471654852/BTComputerSwitch/ENGR Project 01/QQ20180418-174442.png

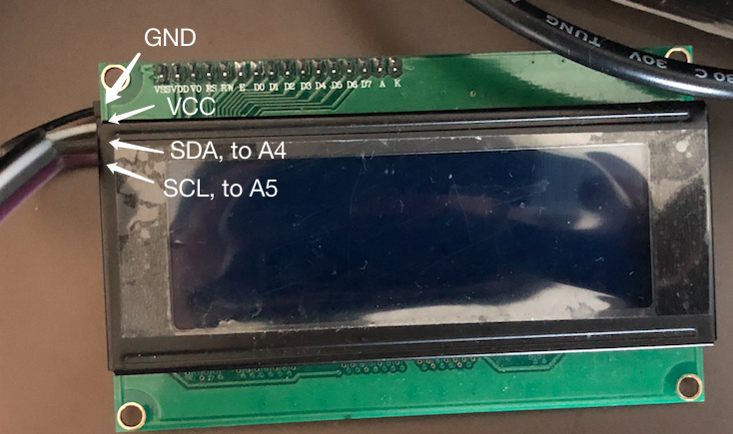
ENGR Project 01/QQ20180418-174442.png
