471654852/BTComputerSwitch/ENGR Project 01/QQ20180418-173207.png

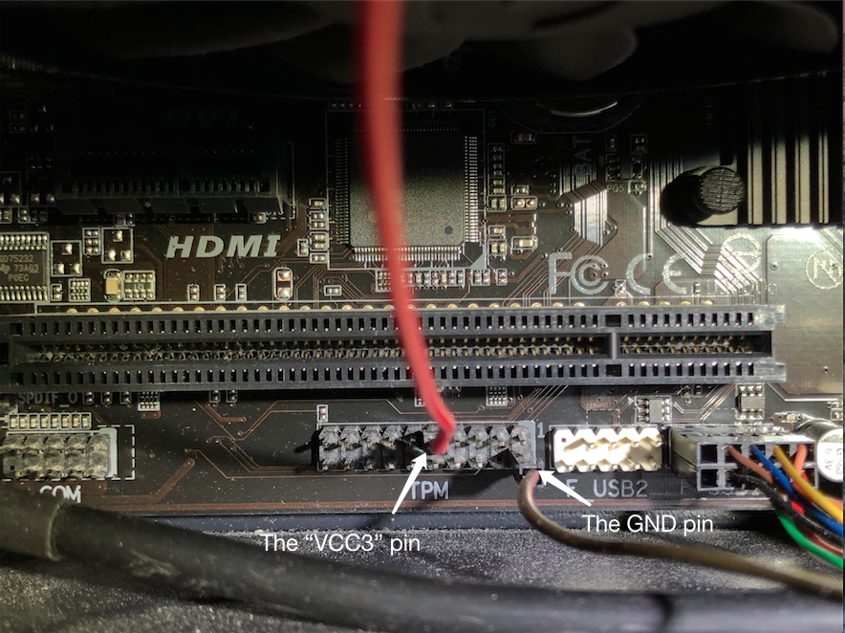
ENGR Project 01/QQ20180418-173207.png
