471654852/BTComputerSwitch/Project.pdf

### 7. Problem Solving

1. Problem statement

Many people forget to turn off their computer when they leave the house, which would

waste a lot of energy. I will design and make a Bluetooth switch for a computer that

connects the ON OFF switch of the computer to their phone. This allows a user who is in the

range of the Bluetooth connection to control the ON OFF switch through their phone. If the

user is outside of the range of the Bluetooth connection, then the switch will turn off the

computer automatically. This will reduce the energy consumption.

### 2. Diagrams

Figure 1.1
The diagram below shows the function of each pin on the TPM header.

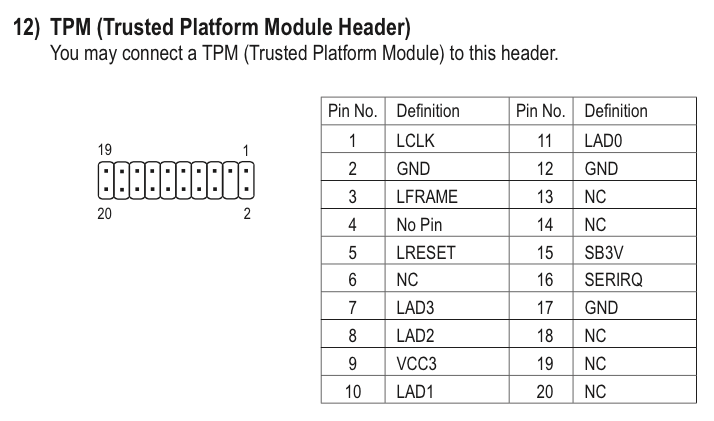
[picture p3: figure]

The TPM header on a motherboard.
From: https://www.gigabyte.com/Motherboard/GA-A320M-HD2-rev-10#support-manual

Figure 1.2
The diagram below shows the function of each pin on the front panel header.

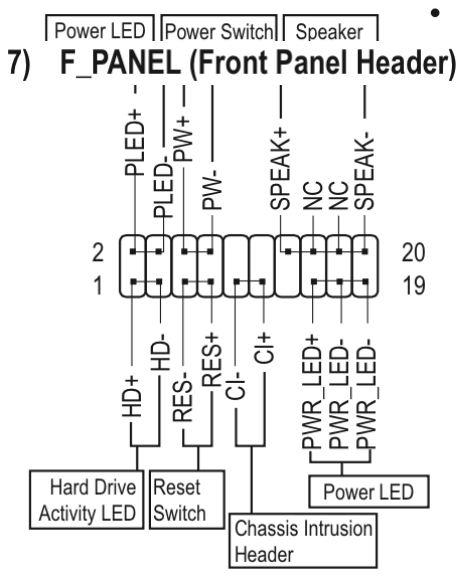
[picture p4: figure]

The front panel header on a mother board.
From: https://www.gigabyte.com/Motherboard/GA-A320M-HD2-rev-10#support-manual

Figure 2
The diagram below explains the voltage divider Law.
This is very important to make a 5V microcontroller and a 3.3V Bluetooth module work together.

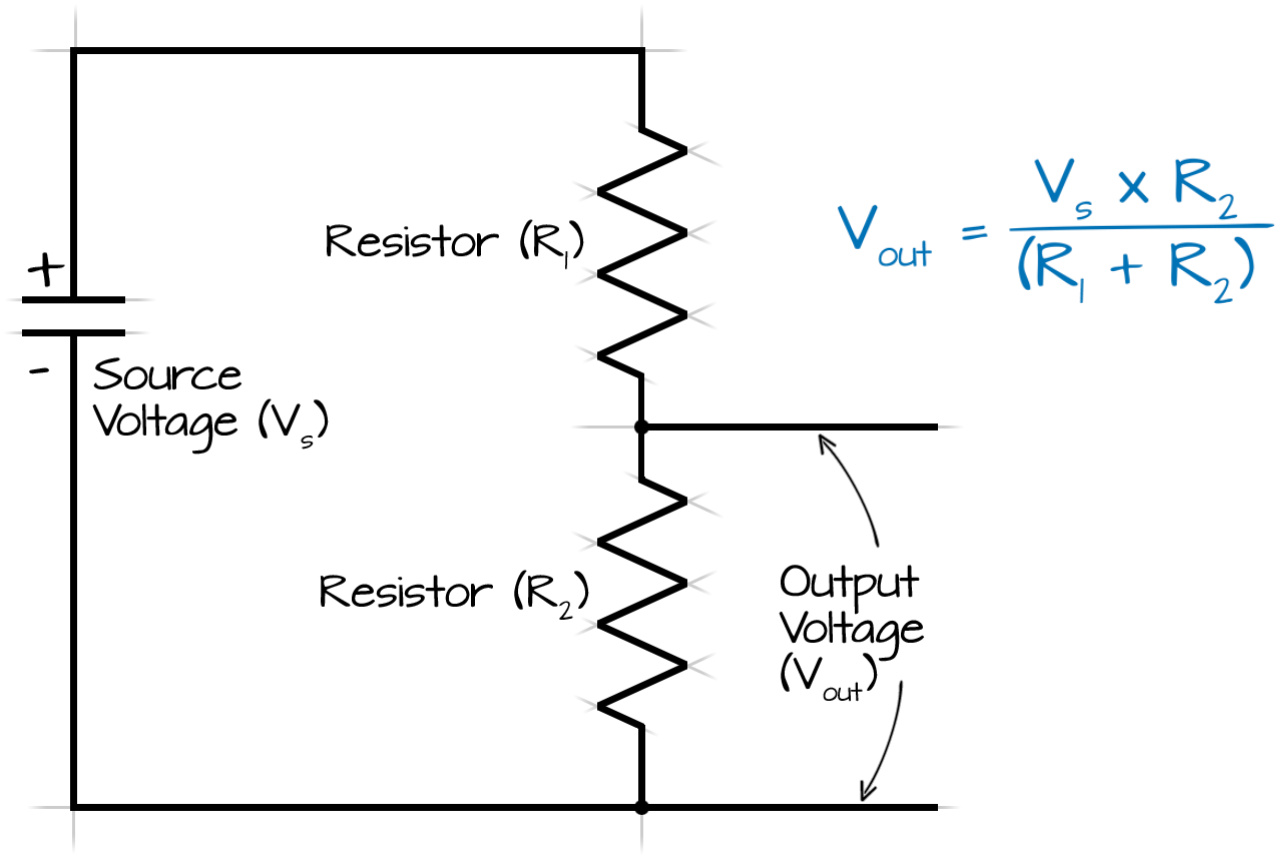
[picture p5: figure]

A voltage divider circuit and the formula based on Ohms Law
From: http://www.ohmslawcalculator.com/voltage-divider-calculator

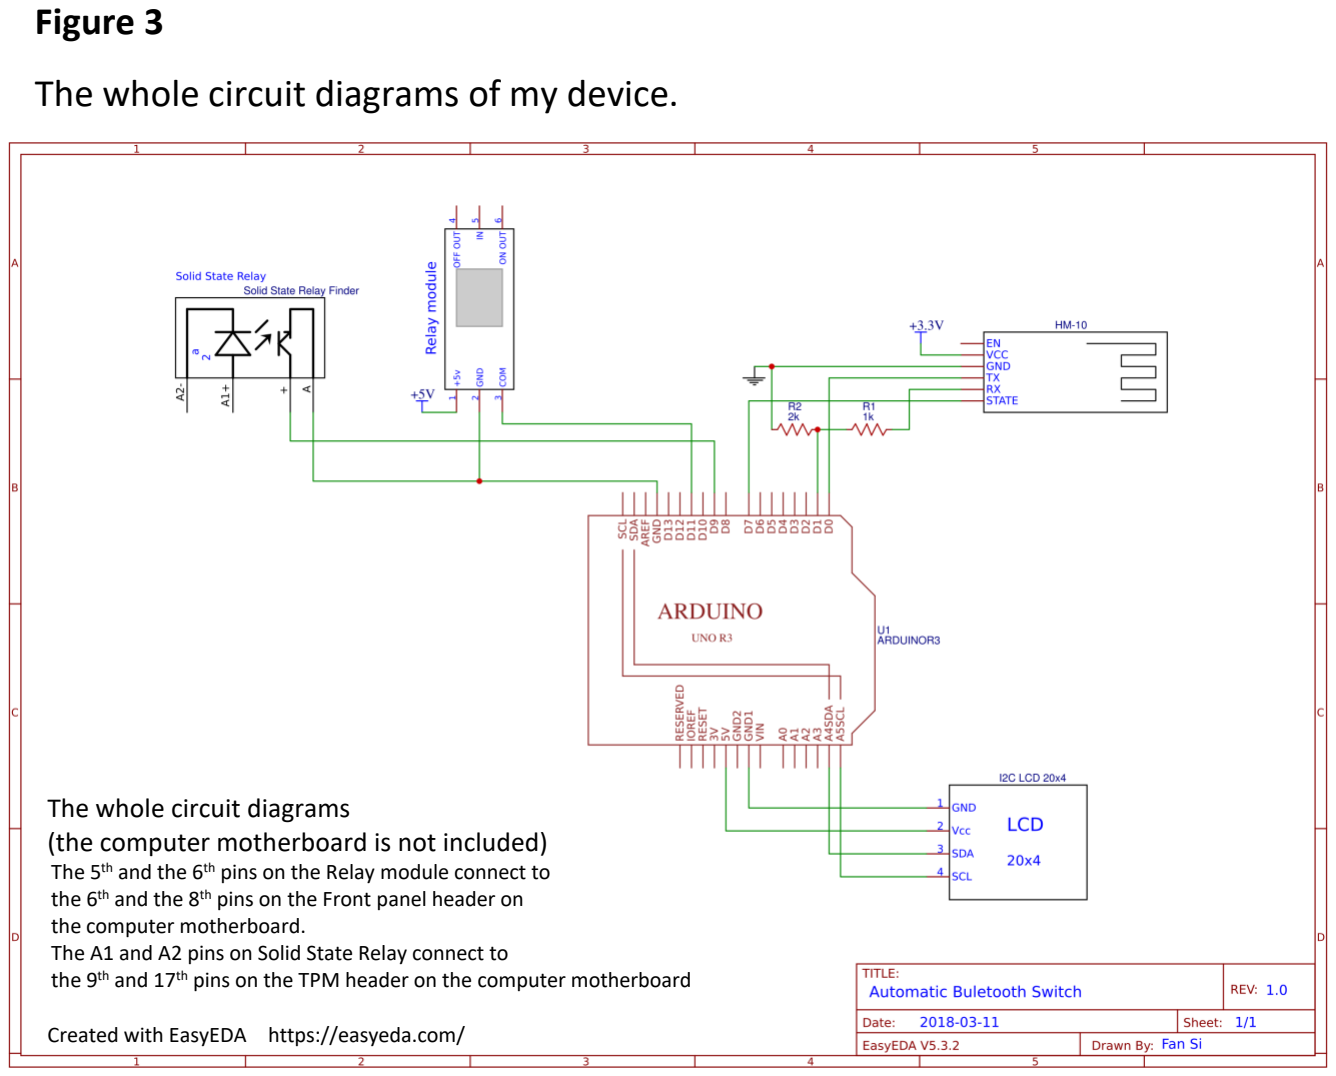
[picture p6: page 4]

Figure 3

The whole circuit diagrams of my device.

The whole circuit diagrams
(the computer motherboard is not included)
The 5th and the 6th pins on the Relay module connect to the 6th and the 8th pins on the Front panel header on
the computer motherboard.
The A1 and A2 pins on Solid State Relay connect to
the 9th and 17th pins on the TPM header on the computer motherboard

Created with EasyEDA https://easyeda.com/

Figure 4
This is the flow chart of my program.
The program will determine the computer power status and then take certain action by checking the Bluetooth connection status or the commands it get.

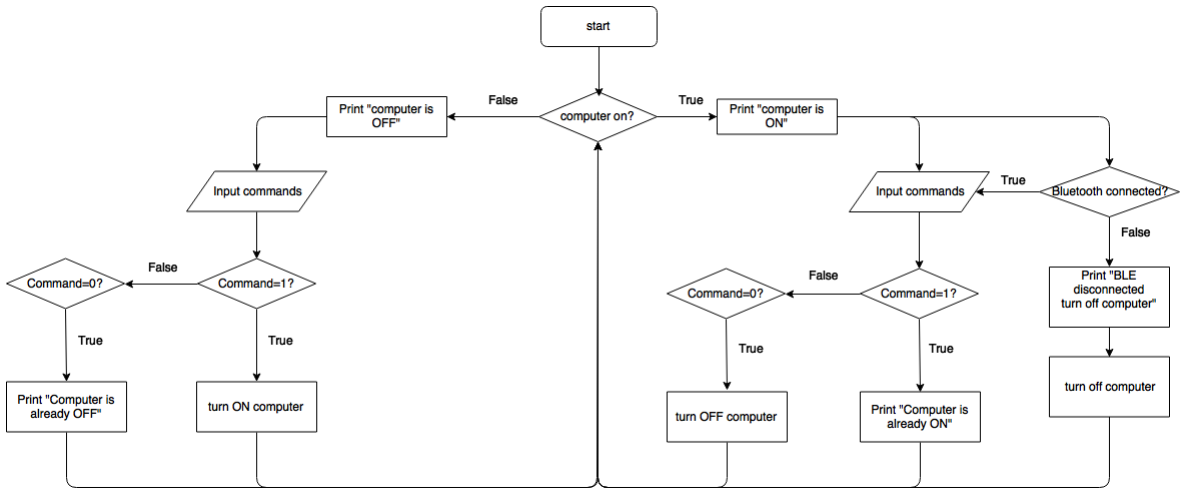
[picture p7: figure]

Created with draw.io

### 3. Theories

a. To turn on and off computer
Short the 6th and the 8th pins on the Front panel header on the motherboard in

figure 1.2 can turn on and off the computer.

b. Determining if the computer is on or off

The 9th pin on the TMP header on the motherboard in figure 1.2 will output 3.3V DC

when the computer is on. This voltage can trigger a low voltage Solid State Relay

with very low current.

c. Determining if the Bluetooth device is still connecting

The status LED on the HM-10 Bluetooth module can set to be turn on or off

continuously when the Bluetooth is connected or Unconnected so that I can read it.

From HM-10 Datasheet
ftp://imall.iteadstudio.com/Modules/IM130614001_Serial_Port_BLE_Module_Master_Slave_HM-10/DS_IM130614001_Serial_Port_BLE_Module_Master_Slave_HM-10.pdf
d. To power my devices

There is an option in the BIOS that the USB ports can still output 5V DC even if the

computer has been turned off.

e. To turn off the computer safely

There is an option in the Windows power setting that the computer can be turn off

normally when the power button pushed.

### 4. Assumptions

a. Must be a desktop computer with a motherboard that I can access.
b. The phone must support BLE 4.0.
c. The phone won’t turn off itself when you are using the computer. If the phone turns

off the computer will turn off.

d. The computer must be able to power my device when it’s off.

### 5. Solution Steps

1. Setup the HM-10 BLE module for working with my project.

The module I got does not has a status pin that connect with the LED VCC on the

module, so for determining the Bluetooth connection I have to modify it by soldering a

jump wire right on the LED VCC.

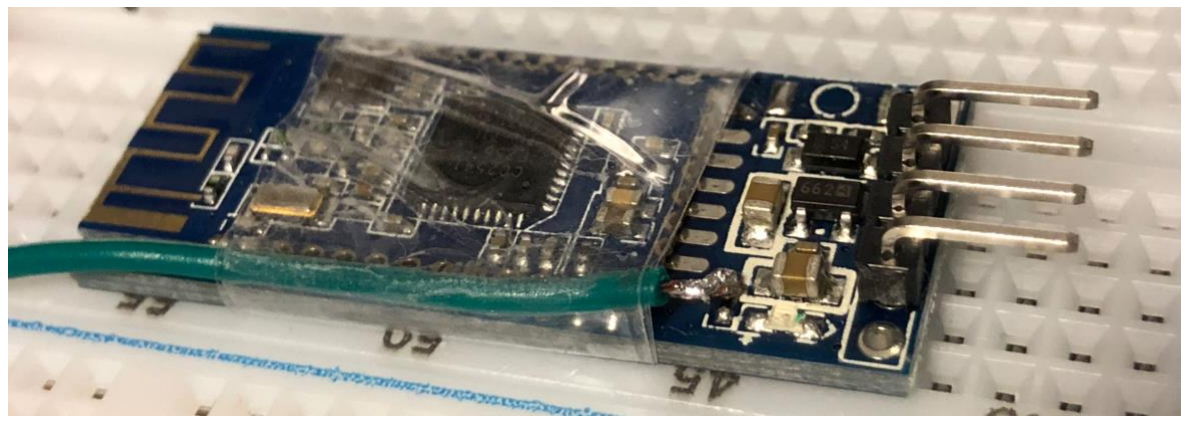
[picture p8: figure]

Then I used some of the instructions and codes on http://www.martyncurrey.com/hm-

10-bluetooth-4ble-modules/ to setup and test my Bluetooth module.

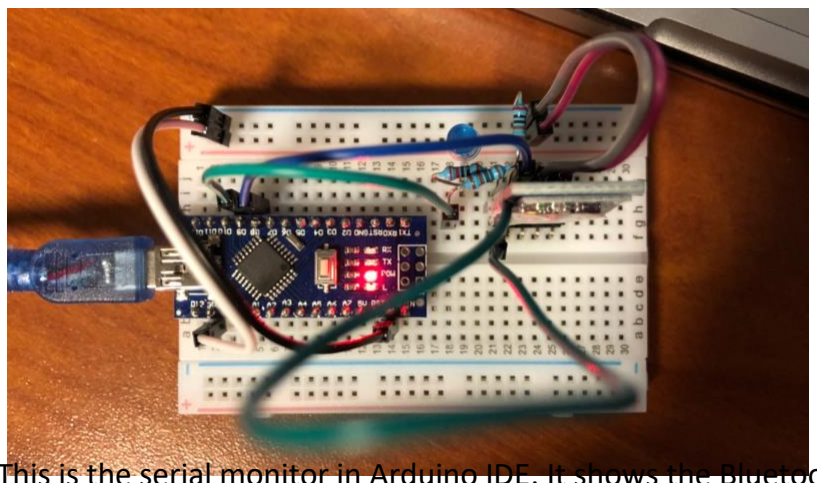
[picture p9: figure]

This is the serial monitor in Arduino IDE. It shows the Bluetooth module works pretty

well and responding to my commands.

I changed the Bluetooth NAME to “Project Test” and the status LED setting.

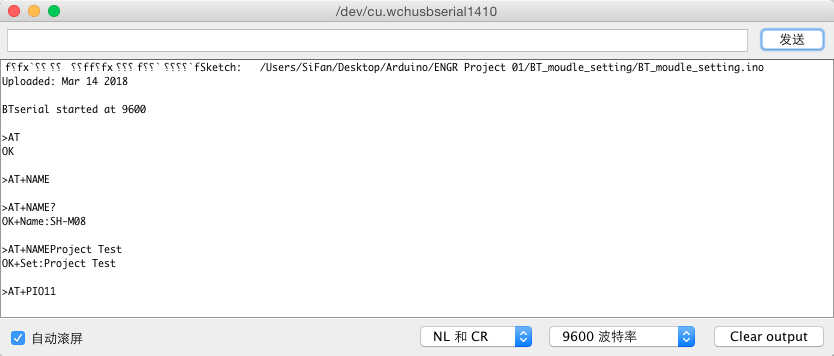
[picture p10: figure]

### 2. Hardware design and connections

I use a relay module to short the power pins in figure 1.2 on the motherboard to turn on or

off the computer and a solid-state relay connect to the TMP VCC3 and GND pins in figure 1.1

to read if the computer is on or off.

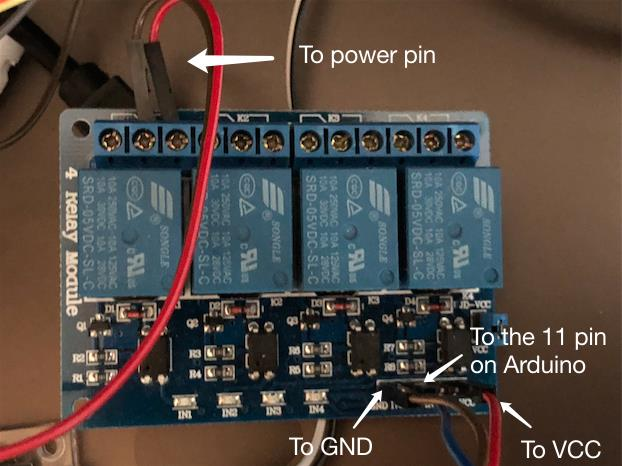
[picture p11: figure]
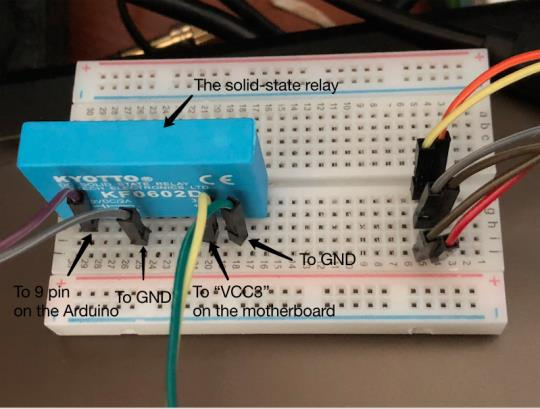
[picture p12: figure]

Future more, the Bluetooth module is a 3.3V device but the Arduino is a 5V device.

Therefore, I need to reduce the voltage on the Arduino TX pin from 5V to 3.3V. I use a 1k

ohm resistor, a 2k ohm resistor, and the voltage divider law in figure 2 to make a voltage

divider as shown in figure 3.

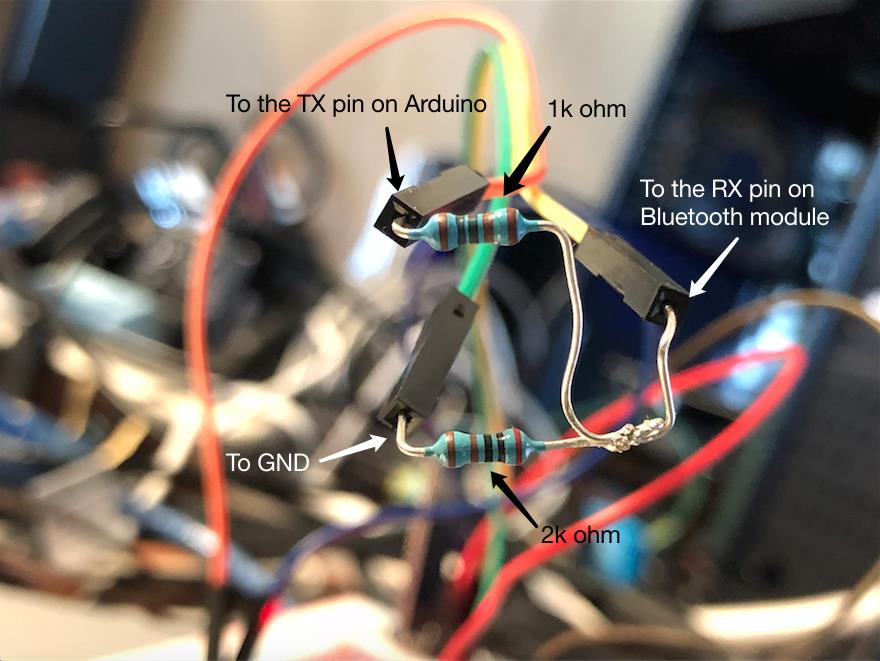
[picture p13: figure]

For better user interaction, I use a I2C LCD screen to show the information about Bluetooth

state, computer power state, and it will show the “power button” state when it “push” the

“power button” These statuses will also send to the phone via Bluetooth.

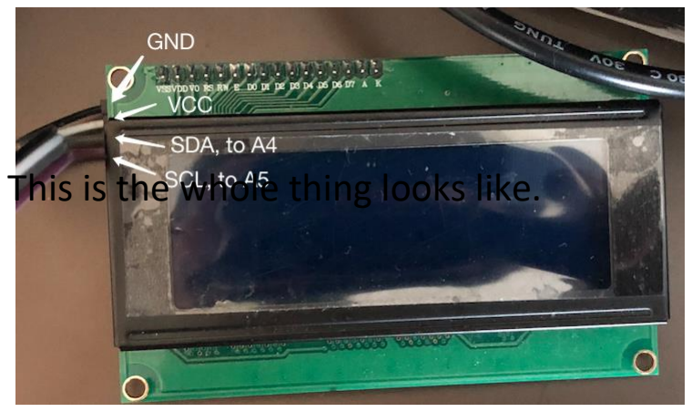
[picture p14: figure]
This is the whole thing looks like.
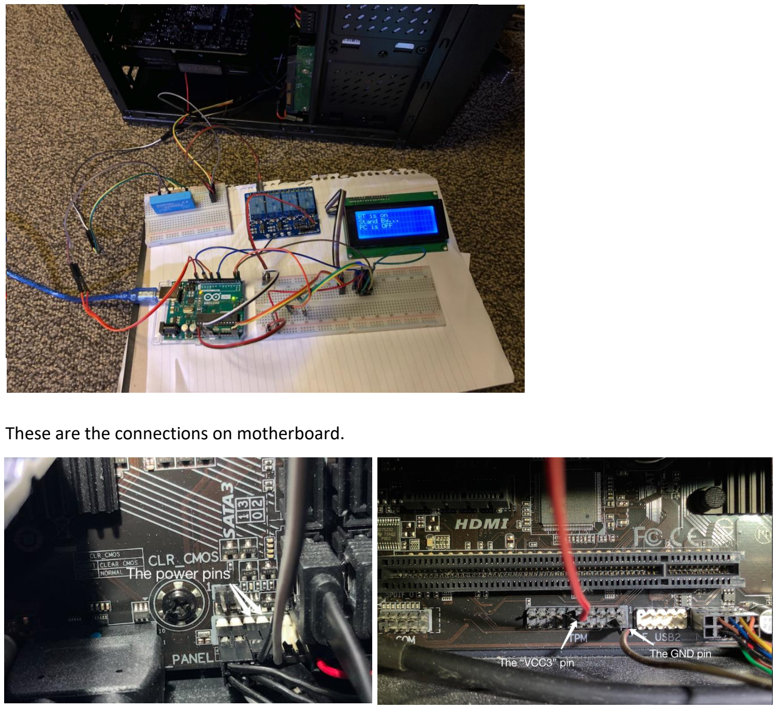
[picture p15: page 10]

These are the connections on motherboard.

3.Coding

I wrote a program to control the Arduino UNO to do works.

This is the first part of my program.

This part is for define the function of each pin on the microcontroller on the Arduino,

initialize the LCD screen and set baud for the Bluetooth module.

I use two libraries called “Wire” and “LiquidCrystal_I2C” from

https://www.arduino.cc/en/Reference/Wire

and https://github.com/marcoschwartz/LiquidCrystal_I2C.

“Wire” allows Arduino to communicate with I2C devices with A4 and A5 ports, that works

with LiquidCrystal_I2C”to control the I2C LCD screen.

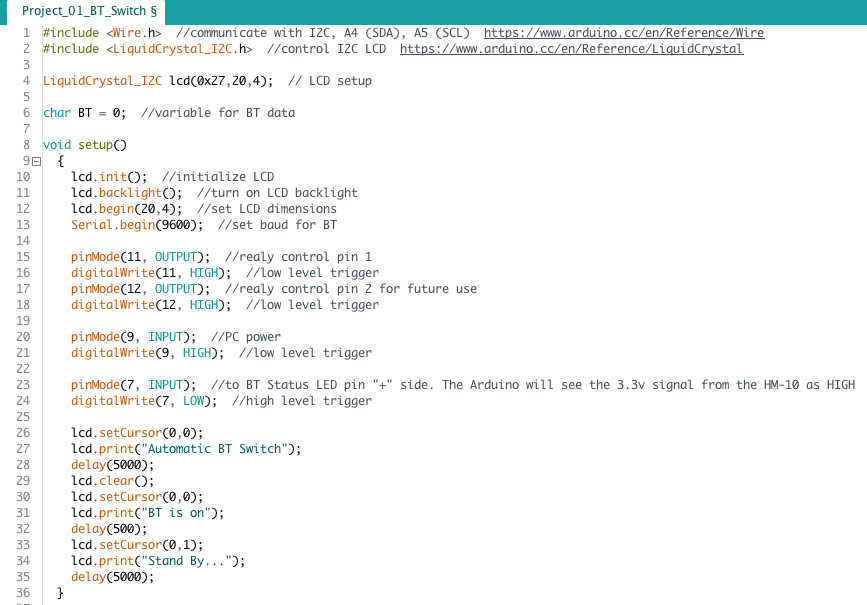
[picture p16: figure]

This is the second part of my program. This part is the logic part.

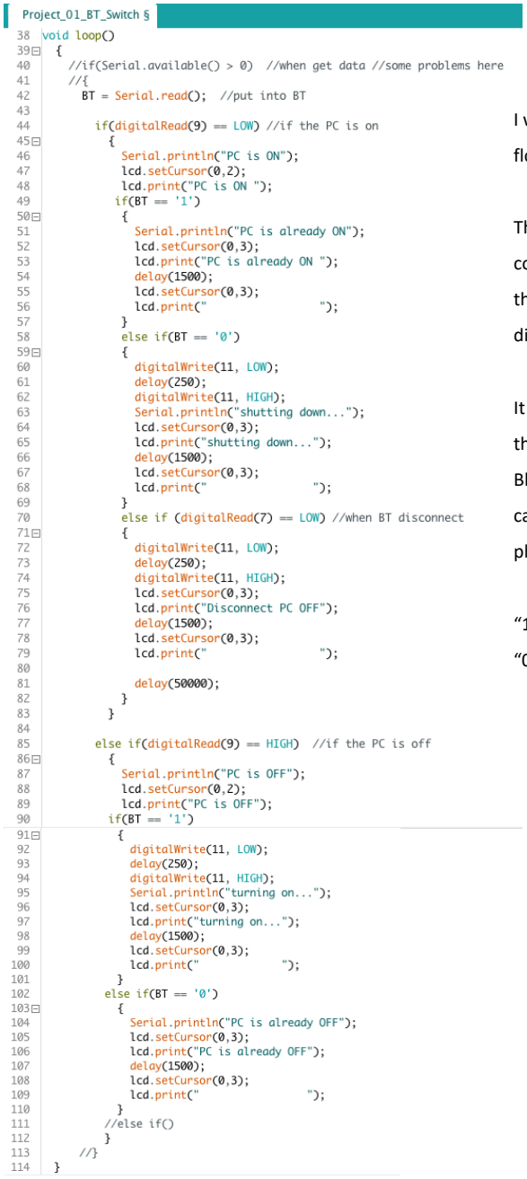
[picture p17: figure]

I wrote all of those codes with my

flow chart in figure 4.

The program will determine if the

computer is on or off and turn off

the computer when Bluetooth

disconnected.

It can also be a remote switch of

the computer with a phone in the

Bluetooth connection range. You

can send commends to it with the

phone.

“1” means turn on the computer

“0” means turn off the computer

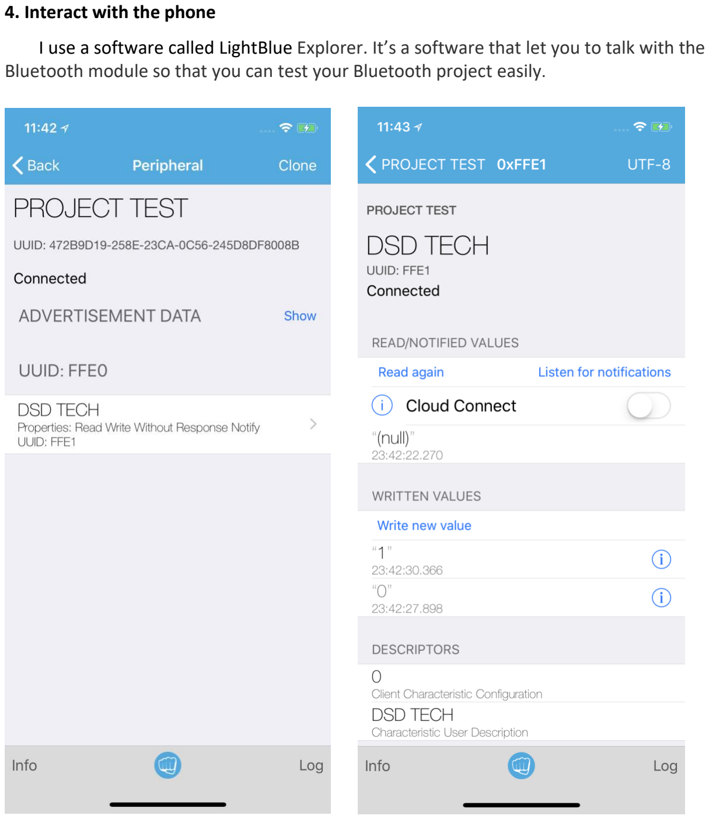
[picture p18: page 13]

### 4. Interact with the phone

I use a software called LightBlue Explorer. It’s a software that let you to talk with the Bluetooth module so that you can test your Bluetooth project easily.

### 6. Result

This link below is a video I made. It shows how my device works.

https://www.bilibili.com/video/av22277399/

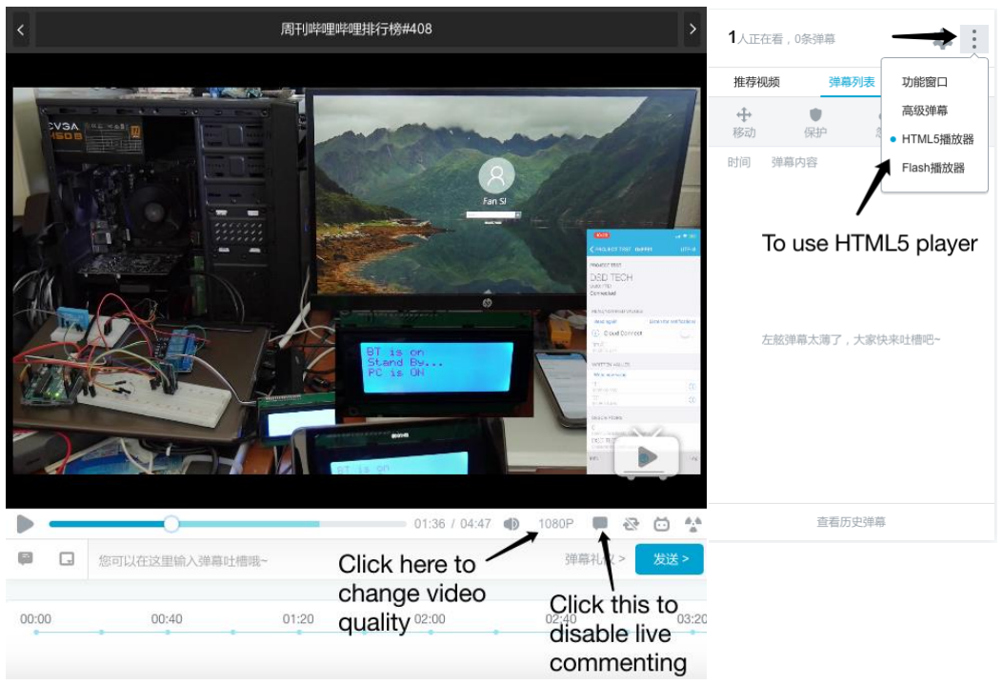
[picture p19: figure]

There should not be any live comment in this video. However, if there are live comments

bothers you, you can turn it off.

### 7. Conclusion & discussion

I tested it by leave the building when my computer is on. After I get back my computer had

been turned off. I also tested it by use my phone to send control commands to the device. It

works pretty well.

To make it better, I will make a PCB to put everything of my device on a signal board instead

of bread boards and jump wires. Then I will make a case for it, so that I can put everything

into the computer.

Next, I will try to make it to do more things. This device can be a smart home device by

simply change the program. It can be an automatic switch for the lights in your room or a

controller of some household appliances. I will also try to make a device that connects to

the internet, so that you can remote everything in your home no matter where you are as

long as you get internet connection. This will reduce energy consumption and bring

convenience to people.
