471654852/BTComputerSwitch/ENGR Project 01/IMG_0751.JPG

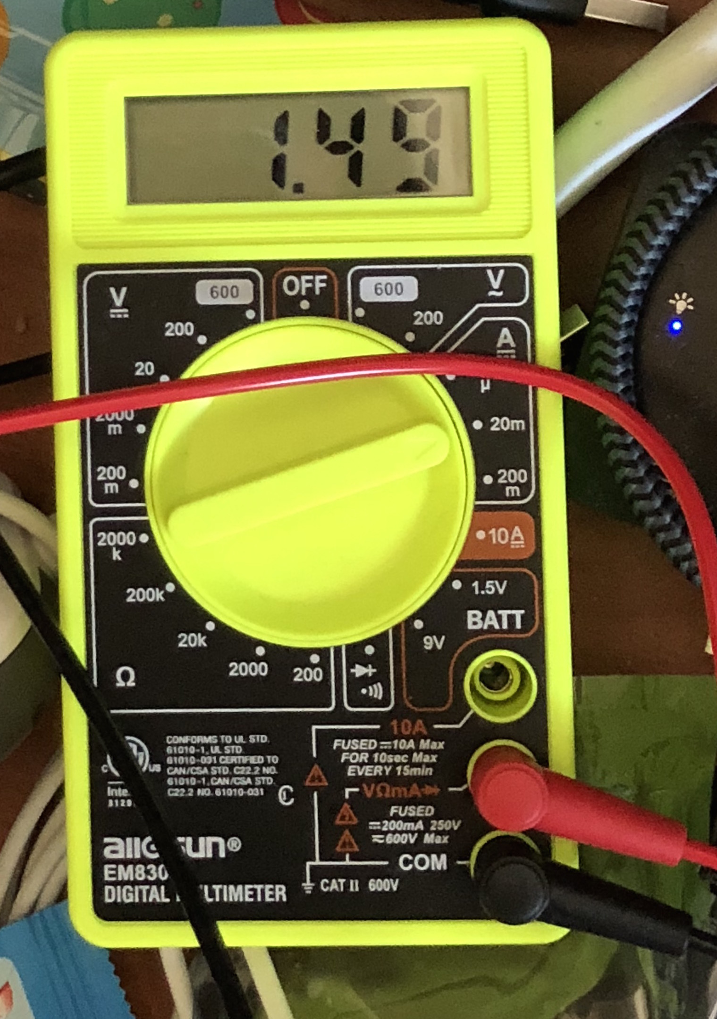
ENGR Project 01/IMG_0751.JPG
