471654852/BTComputerSwitch/ENGR Project 01/IMG_0765.JPG

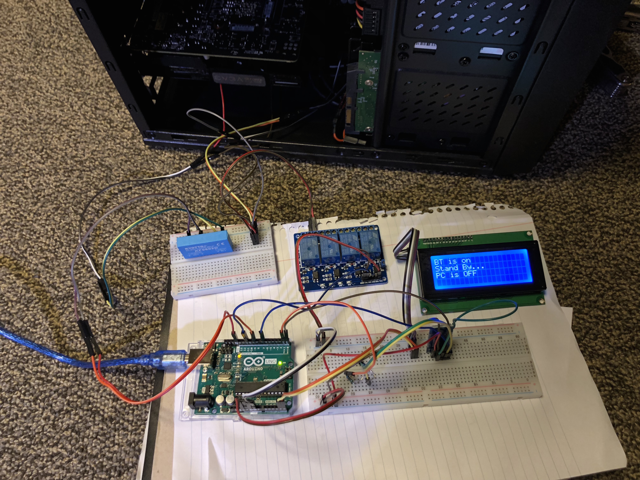
ENGR Project 01/IMG_0765.JPG
