471654852/BTComputerSwitch/ENGR Project 01/QQ20180418-173101.png

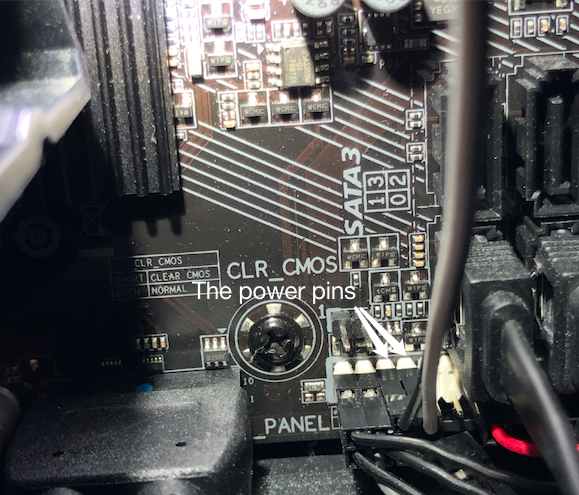
ENGR Project 01/QQ20180418-173101.png
