471654852/BTComputerSwitch/ENGR Project 01/Schematic_ENGR102-Project-01_Sheet-1_20180312102718.png

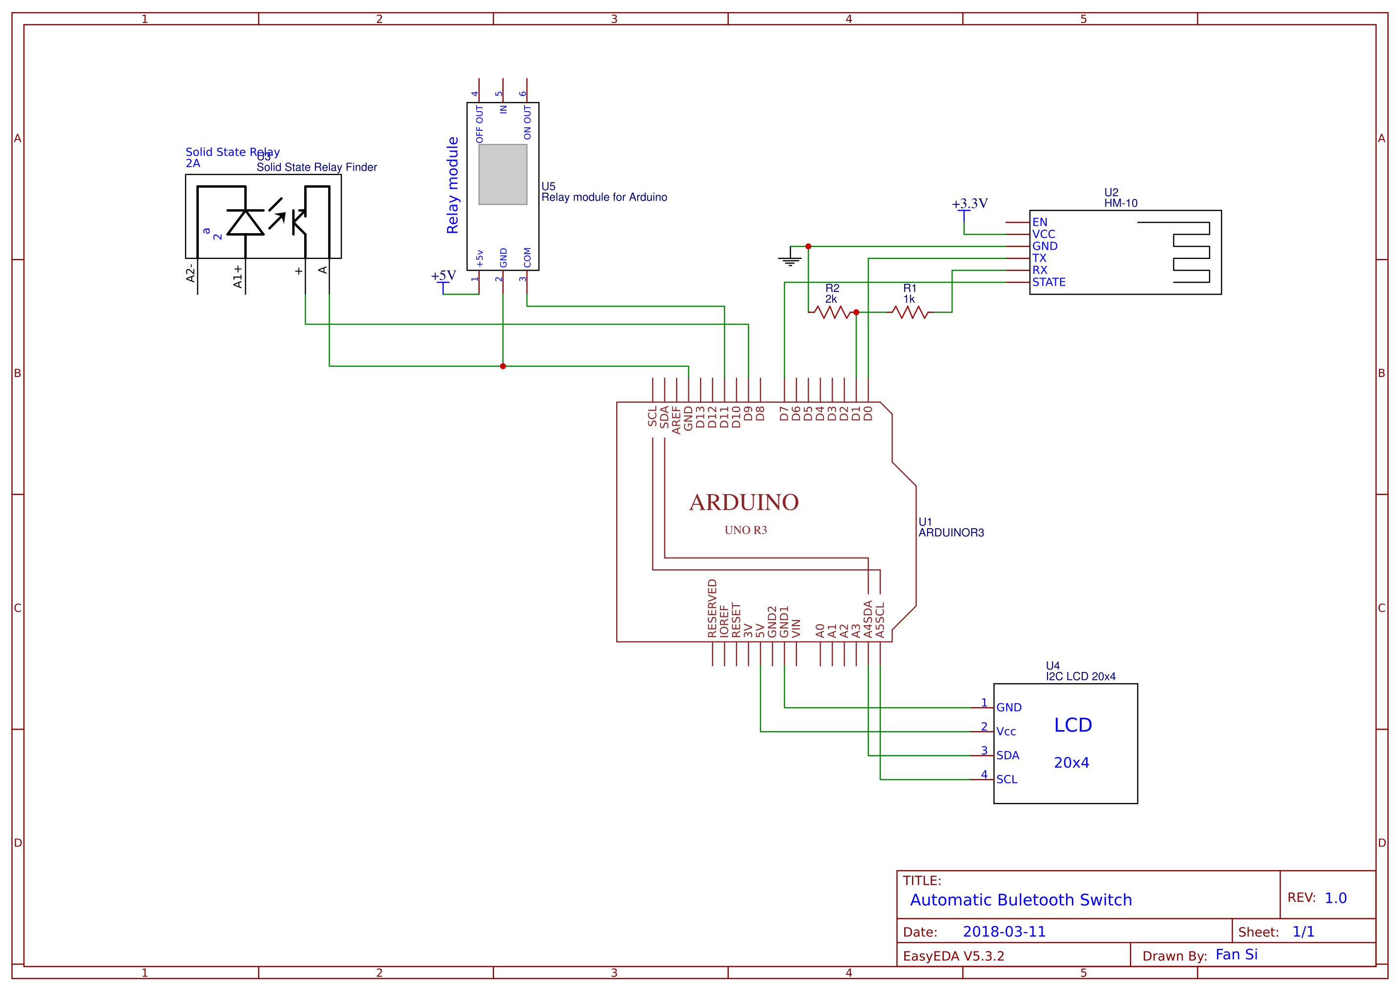
ENGR Project 01/Schematic_ENGR102-Project-01_Sheet-1_20180312102718.png
