471654852/BTComputerSwitch/ENGR Project 01/Schematic_ENGR102-Project-01_Sheet-1_20180326161525.pdf

+3.3V

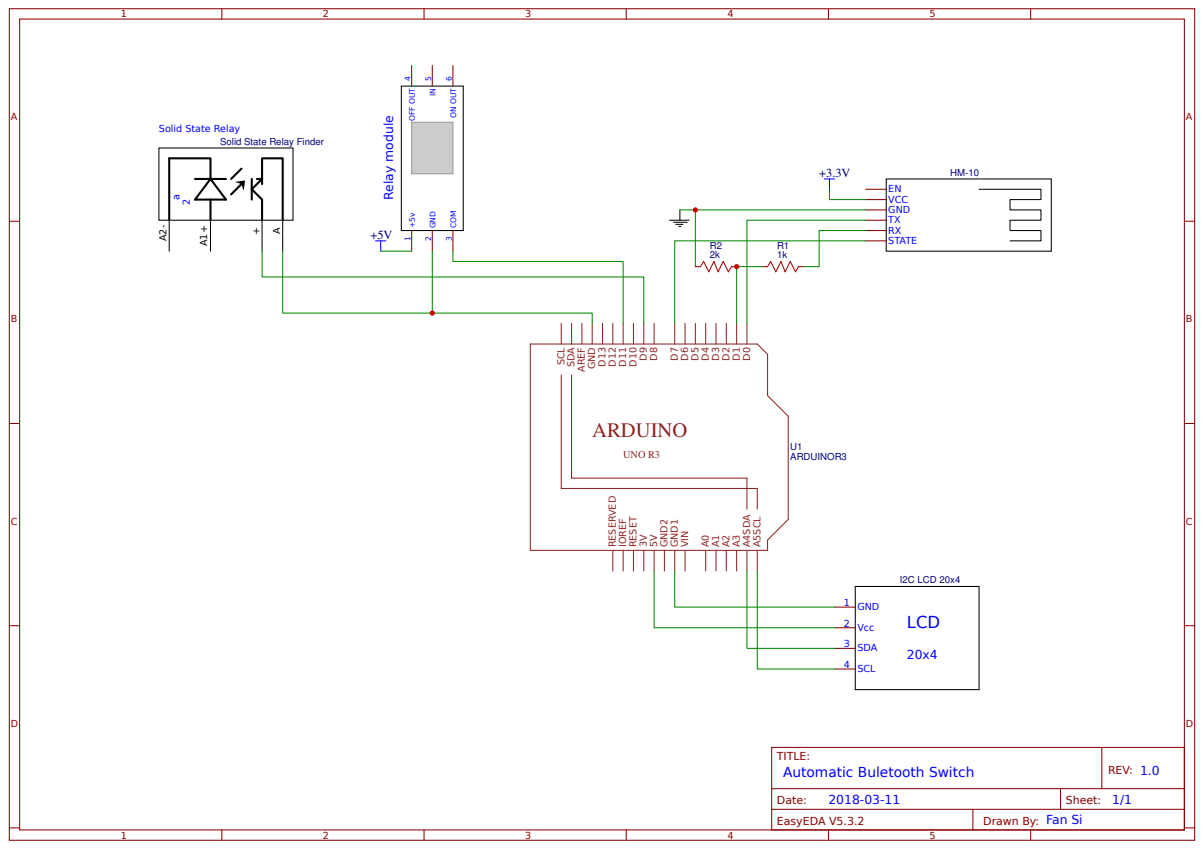
[picture p24: page 1]

Solid State Relay Finder
